AYMEN-KLAI/Autonomous-Maze-Solving-Robot-Based-on-STM32F446RE/Core/Inc/main.h

#define USART_TX_Pin GPIO_PIN_2
#define USART_TX_GPIO_Port GPIOA
#define USART_RX_Pin GPIO_PIN_3
#define USART_RX_GPIO_Port GPIOA
#define LD2_Pin GPIO_PIN_5
#define LD2_GPIO_Port GPIOA
#define TRIG_FRONT_Pin GPIO_PIN_0
#define TRIG_FRONT_GPIO_Port GPIOB
#define ECHO_FRONT_Pin GPIO_PIN_1
#define ECHO_FRONT_GPIO_Port GPIOB
#define TRIG_LEFT_Pin GPIO_PIN_2
#define TRIG_LEFT_GPIO_Port GPIOB
#define ECHO_LEFT_Pin GPIO_PIN_10
#define ECHO_LEFT_GPIO_Port GPIOB
#define TRIG_RIGHT_Pin GPIO_PIN_12
#define TRIG_RIGHT_GPIO_Port GPIOB
#define ECHO_RIGHT_Pin GPIO_PIN_13
#define ECHO_RIGHT_GPIO_Port GPIOB
#define TMS_Pin GPIO_PIN_13
#define TMS_GPIO_Port GPIOA
#define TCK_Pin GPIO_PIN_14
#define TCK_GPIO_Port GPIOA
#define SWO_Pin GPIO_PIN_3
#define SWO_GPIO_Port GPIOB
