AYMEN-KLAI/Autonomous-Maze-Solving-Robot-Based-on-STM32F446RE/(commit log)

2026-06-08 Enhance README with technical overview and achievements
    Added a comprehensive technical overview and project achievements for the STM32F446RE maze-solving robot, detailing its design, performance, and competitive recognition.
2026-06-08 Enhance README with detailed project overview
    Expanded the README with detailed sections on project introduction, core control unit, sensor integration, inertial navigation, actuation, algorithmic navigation, and tournament performance.
